bscher/arduino-SmartHelmet/HelmetController/DisplayGraphics.cpp

#include "System.h"
#include "DisplayGraphics.h"

const unsigned char splashScreen[] PROGMEM = {
   0x00, 0x00, 0x00, 0x00, 0x00, 0x00, 0x00, 0x00, 0x00, 0x00, 0x00, 0x00, 0x00, 0x00, 0x00, 0x00,
   0x00, 0x00, 0x00, 0x00, 0x00, 0x00, 0x00, 0x00, 0x00, 0x00, 0x00, 0x00, 0x00, 0x00, 0x00, 0x00,
   0x00, 0x00, 0x00, 0x00, 0x00, 0x00, 0x00, 0x00, 0x00, 0x00, 0x00, 0x00, 0x00, 0x00, 0x00, 0x00,
   0x00, 0x00, 0x00, 0x00, 0x00, 0x00, 0x00, 0x00, 0x00, 0x00, 0x00, 0x00, 0x00, 0x00, 0x00, 0x00,
   0x00, 0x00, 0x00, 0x00, 0x00, 0x00, 0x00, 0x00, 0x00, 0x00, 0x00, 0x00, 0x00, 0x00, 0x00, 0x00,
   0x00, 0x00, 0x00, 0x00, 0x00, 0x00, 0x00, 0x00, 0x00, 0x00, 0x00, 0x00, 0x00, 0x00, 0x00, 0x00,
   0x3f, 0xff, 0xff, 0xff, 0xff, 0xff, 0xff, 0xff, 0xff, 0xff, 0xff, 0xff, 0xff, 0xff, 0xff, 0xfe,
   0x3f, 0xff, 0xff, 0xff, 0xff, 0xff, 0xff, 0xff, 0xff, 0xff, 0xff, 0xff, 0xff, 0xff, 0xff, 0xfe,
   0x00, 0x00, 0x00, 0x00, 0x00, 0x00, 0x00, 0x00, 0x00, 0x00, 0x00, 0x00, 0x00, 0x00, 0x00, 0x00,
   0x00, 0x00, 0x00, 0x00, 0x00, 0x00, 0x00, 0x00, 0x00, 0x00, 0x00, 0x00, 0x00, 0x00, 0x00, 0x00,
   0x00, 0x00, 0x00, 0x00, 0x00, 0x00, 0x00, 0x00, 0x00, 0x00, 0x00, 0x00, 0x00, 0x00, 0x00, 0x00,
   0x07, 0x86, 0x03, 0x02, 0x07, 0xe1, 0xff, 0x00, 0x80, 0x4f, 0xf2, 0x01, 0x80, 0xcf, 0xf7, 0xfc,
   0x08, 0x46, 0x03, 0x02, 0x04, 0x10, 0x10, 0x00, 0x80, 0x48, 0x02, 0x01, 0x80, 0xc8, 0x00, 0x40,
   0x10, 0x25, 0x05, 0x05, 0x04, 0x08, 0x10, 0x00, 0x80, 0x48, 0x02, 0x01, 0x41, 0x48, 0x00, 0x40,
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
//	0x01, 0xfc, 0x00, 0x07, 0xf0, 0x00, 0x0f, 0xe0, 0x00, 0x07, 0xc0, 0x00, 0x03, 0xf8, 0x00, 0x00,
//	0x7f, 0x00, 0x00, 0x07, 0xf0, 0x00, 0x00, 0xfc, 0x00, 0x00, 0x1e, 0x00, 0x00, 0x01, 0x00, 0x00,
//	0x00, 0x0
//};
