bscher/arduino-SmartHelmet/HelmetController/Display.h

#ifndef _DISPLAY_H_
#define _DISPLAY_H_

#include "System.h"
#include "SignalData.h"

#include <SPI.h>
#include <Wire.h>
#include <Adafruit_GFX.h>
#include <Adafruit_SSD1306.h>
#include <Fonts/FreeMonoBoldOblique12pt7b.h>

namespace Display
{
	void init(void);

	void drawNoSignal(void);
	void draw(SignalData d);
	void testGraphics(void);
	void testArrows(Adafruit_SSD1306, int);
};

#endif
