bscher/arduino-SmartHelmet/HelmetController/DisplayGraphics.h

#ifndef _DISPLAY_GRAPHICS_H_
#define _DISPLAY_GRAPHICS_H_

#include "System.h"

extern const unsigned char splashScreen[] PROGMEM;
extern const unsigned char noSignal_1[] PROGMEM;
extern const unsigned char noSignal_2[] PROGMEM;
extern const unsigned char noSignal_3[] PROGMEM;
extern const unsigned char noSignal_4[] PROGMEM;
//extern const unsigned char stars_5[] PROGMEM;
//extern const unsigned char warning_5[] PROGMEM;
//extern const unsigned char warning_left[] PROGMEM;

#endif
