bscher/arduino-SmartHelmet/(commit log)

2017-03-23 Test changed. (Not working?)
    [Display.cpp, DisplayTest.ino]
2017-03-23 Sensors now buffered. Only sensor A.
